DrAndrewThaler/reStepper/ShapeFiles/README.md

# Shape Files for reStepper

Includes .svg files for base, 3mm parts, and 6mm parts, as well as .dxf file for the entire project. Base is designed to be cut from 3mm acrylic. With clever positioning, the entire project can be cut from 3 sheets of Glowforge proof-grade acrylic. 

Developed by [Andrew Thaler](https://twitter.com/DrAndrewThaler).

Please visit my [Patreon page](https://www.patreon.com/Andrew_Thaler) to support more weird and wonderful projects like this.
