DrAndrewThaler/reStepper/Arduino/README.md

# Arduino Source Code for reStepper

This code will allow the reStepper to run on an Adafruit Metro or other similar Arduino-based microcontroller. Check the code comments for pinout guide. 

Rotary encoder source code from [bildr article](http://bildr.org/2012/08/rotary-encoder-arduino/).

Developed by [Andrew Thaler](https://twitter.com/DrAndrewThaler).

Please visit my [Patreon page](https://www.patreon.com/Andrew_Thaler) to support more weird and wonderful projects like this.
