DrAndrewThaler/reStepper/(list of files, cad)

Other CAD files:
ShapeFiles/reStepper.dxf
